silllies/uranus-fpga-board/BOM_HUMAN.csv

Name | Price | Quantity | Description | Link
Nanya Tech NT5CB64M16GP-FL | 6.11 | 4 | RAM 16 bit | https://www.lcsc.com/product-detail/C27258648.html?s_z=n_q_NT5CB64M16GP
AMD/Xilinx Kintex-7 XC7K325T-3FFG900E | 74.26 | 1 | Main FPGA | https://www.lcsc.com/product-detail/C19273096.html?s_z=s_p_XC7K325T-3FFG900E
AK7DAF1-200.0000T2 | 8.91 | 1 | 200 MHz Crystal Oscillator | https://www.digikey.com/en/products/detail/abracon-llc/AK7DAF1-200-0000T2/10268673
Samtec ASP-134488-01 | 24.74 | 1 | FMC HPC | https://www.lcsc.com/product-detail/C2762238.html?s_z=n_q_ASP-134488-01
Total Cost | 132.35
