silllies/uranus-fpga-board/KiCad/uranus-fpga-board/uranus-fpga-board.kicad_pcb

## KiCad design KiCad/uranus-fpga-board/uranus-fpga-board.kicad_pcb (2026-10-22)

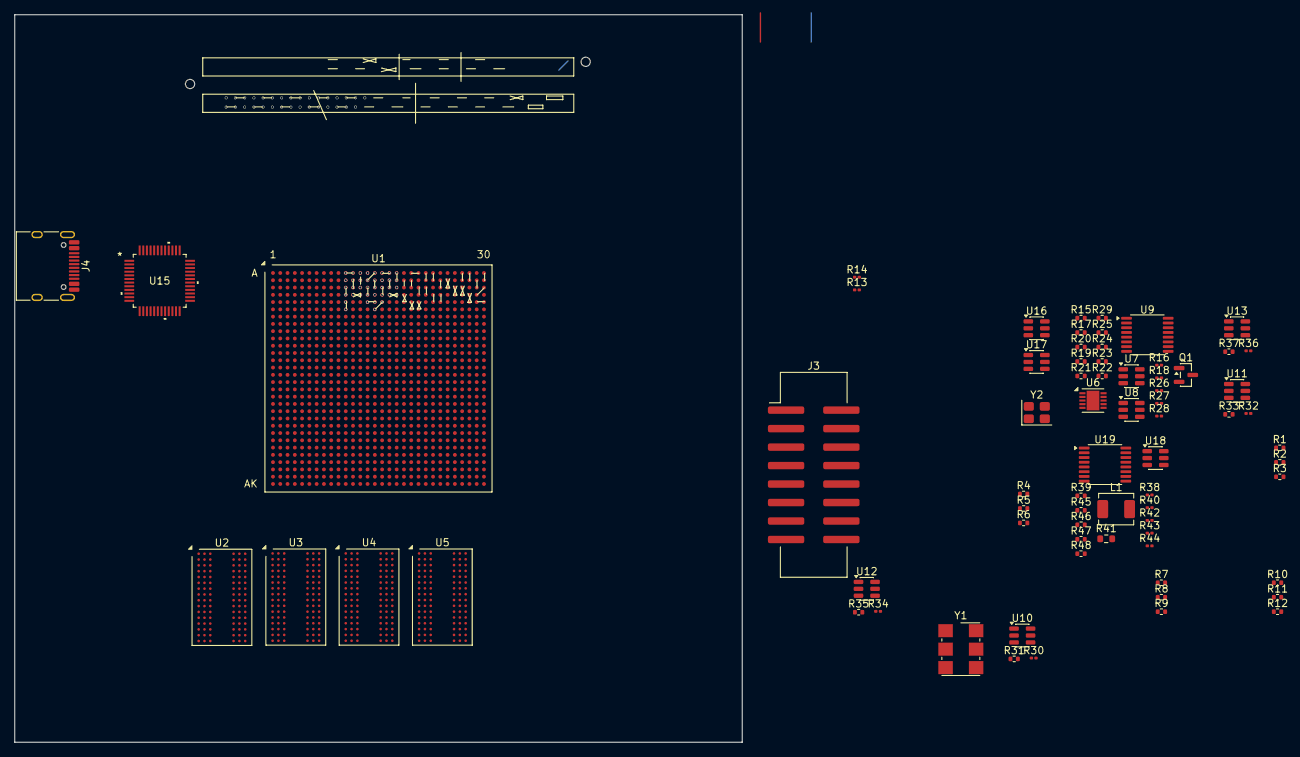
[picture p41: board KiCad/uranus-fpga-board/uranus-fpga-board.kicad_pcb from above]

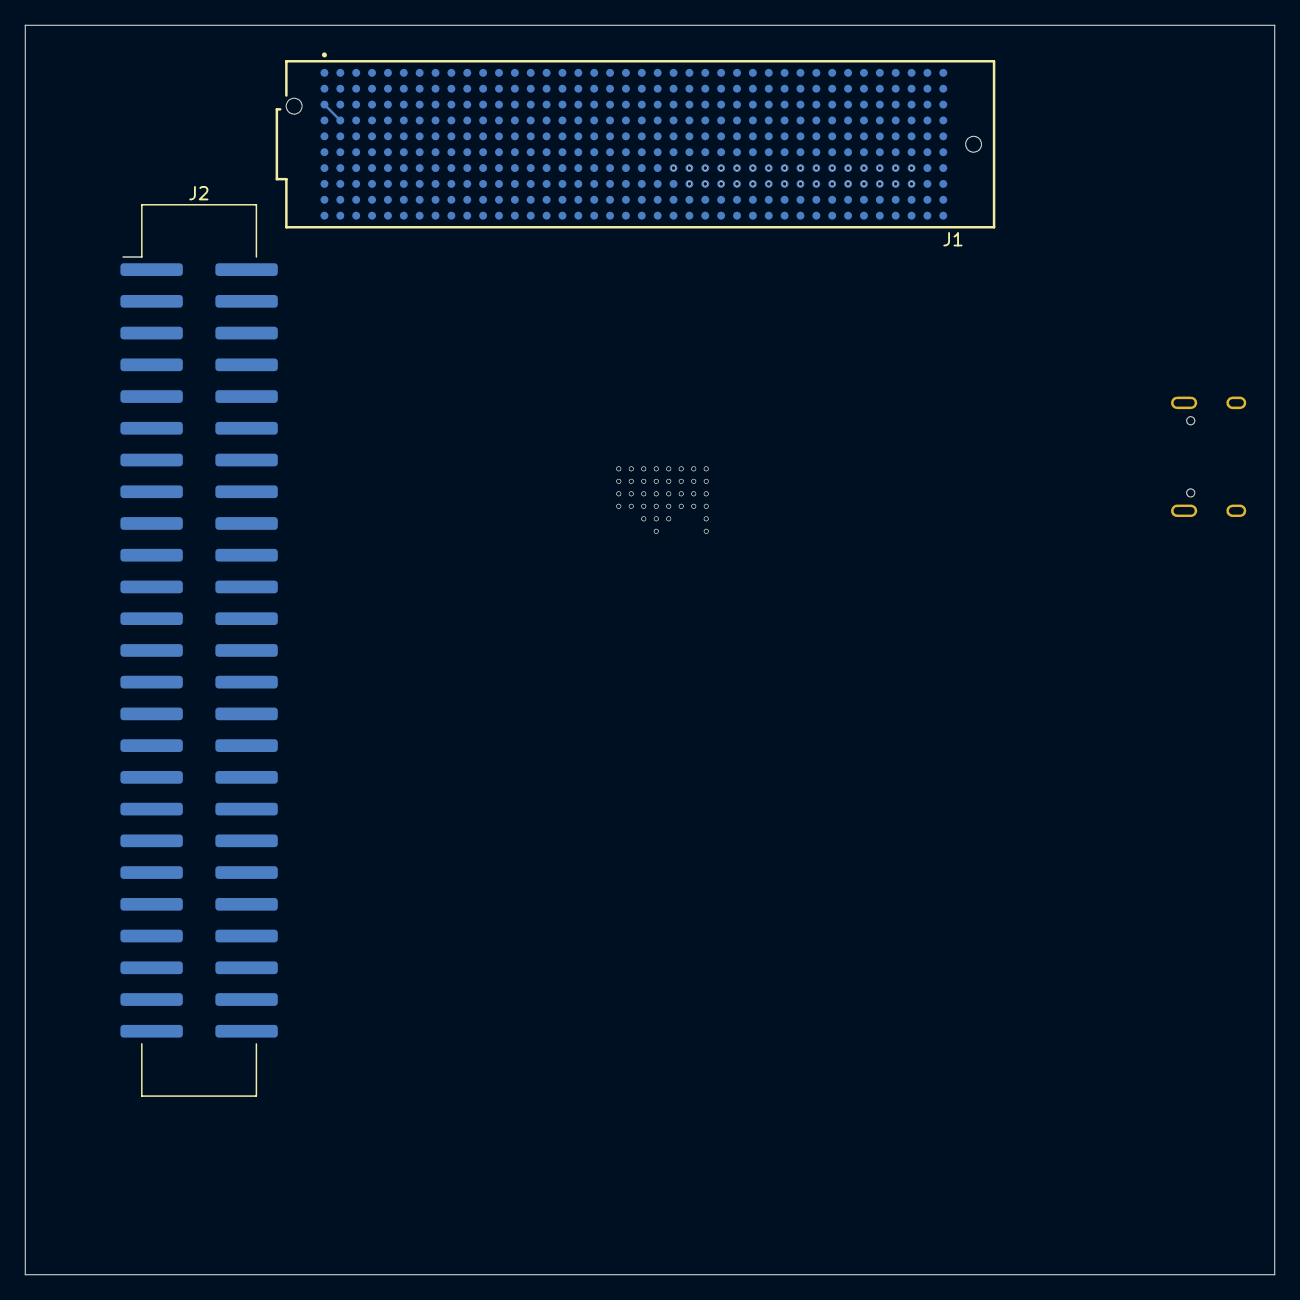
[picture p42: board KiCad/uranus-fpga-board/uranus-fpga-board.kicad_pcb from below]

Board: 8 copper layers, 100.0 x 100.0 mm, 74 parts (2 on the bottom side), 244 nets.

Parts:
J1: ASP-134486-01; SAMTEC_ASP-134486-01
J2: 1040100018; IDC-Header_2x25_P2.54mm_Vertical_SMD
J3: IDC 2x8; IDC-Header_2x08_P2.54mm_Vertical_SMD
J4: TYPE-C-31-M-12; USB_C_Receptacle_HRO_TYPE-C-31-M-12
L1: 2.2 μH; L_Chilisin_BMRA00040415
Q1: 2N7002; SOT-23
R1, R2, R4, R5, R7, R8, R10, R11: 1 kΩ; R_0402_1005Metric
R3, R6, R9, R12: 240 Ω; R_0402_1005Metric
R13, R14, R16, R38: 10 kΩ; R_0201_0603Metric
R15: 1.8 kΩ; R_0402_1005Metric
R17: 200 kΩ; R_0402_1005Metric
R18: 7.5 kΩ; R_0201_0603Metric
R19, R20, R22: 57.6 kΩ; R_0402_1005Metric
R21: 232 kΩ; R_0402_1005Metric
R23: 41.2 kΩ; R_0402_1005Metric
R24: 27.4 kΩ; R_0402_1005Metric
R25: 21.5 kΩ; R_0402_1005Metric
R26, R27, R28, R42, R43, R44: 200 kΩ; R_0201_0603Metric
R29: 15.8 kΩ; R_0402_1005Metric
R30, R32, R34, R36: 499 Ω; R_0201_0603Metric
R31, R33, R35, R37: 7.68 kΩ; R_0402_1005Metric
R39: 4.7 kΩ; R_0402_1005Metric
R40: 30 kΩ; R_0201_0603Metric
R41: 8.98 kΩ; R_0603_1608Metric
R45: 13 kΩ; R_0402_1005Metric
R46: 22.1 kΩ; R_0402_1005Metric
R47: 30.9 kΩ; R_0402_1005Metric
R48: 52.3 kΩ; R_0402_1005Metric
U1: XC7K325T-3FFG900E; Xilinx_FFG900_FFG901
U2, U3, U4, U5: NT5CB64M16GP-FL; FBGA-96_8x13mm_Layout9x16_P0.8mm
U6: SY6874DBC; DFN-10-1EP_3x3mm_P0.5mm_EP1.75x2.7mm
U7: TPS2553DBVR; SOT-23-6
U8: SY6288F1ABC; SOT-23-6
U9, U19: TMUX1108; TSSOP-16_4.4x5mm_P0.65mm
U10, U11, U12, U13: TLV6700DDCR; SOT-23-6
U15: FT232HL-REEL; LQFP48_FT232HL_FTD
U16: 93LC56BT; SOT-23-6
U17: USBLC6-2SC6; SOT-23-6
U18: TPS564201DDCR; SOT-23-6
Y1: SX7DF200.000B20F30DNN; Oscillator_SMD_IDT_JU6-6_7.0x5.0mm_P2.54mm
Y2: 3225-12-20-10-10/4B; Crystal_SMD_3225-4Pin_3.2x2.5mm

Connections:
+1V0: U1.M11 (VCCINT), U1.M13 (VCCINT), U1.M15 (VCCINT), U1.M17 (VCCINT), U1.N10 (VCCINT), U1.N12 (VCCINT), U1.N14 (VCCINT), U1.N16 (VCCBRAM), U1.N18 (VCCINT), U1.P11 (VCCINT), U1.P17 (VCCINT), U1.R10 (VCCINT), U1.R12 (VCCINT), U1.R16 (VCCBRAM), U1.R18 (VCCINT), U1.T11 (VCCINT), U1.T17 (VCCINT), U1.U10 (VCCINT), U1.U12 (VCCINT), U1.U16 (VCCBRAM), U1.U18 (VCCINT), U1.V17 (VCCINT), U1.W16 (VCCBRAM), U1.W18 (VCCINT)
+1V5: R1.1, R4.1, R7.1, R10.1, U1.AA9 (VCCO_33), U1.AA19 (VCCO_32), U1.AB16 (VCCO_32), U1.AC3 (VCCO_34), U1.AC13 (VCCO_33), U1.AD10 (VCCO_33), U1.AE7 (VCCO_34), U1.AE17 (VCCO_32), U1.AF4 (VCCO_34), U1.AF14 (VCCO_32), U1.AG1 (VCCO_34), U1.AG11 (VCCO_33), U1.AH8 (VCCO_34), U1.AH18 (VCCO_32), U1.AJ5 (VCCO_34), U1.AJ15 (VCCO_32), U1.AK2 (VCCO_34), U1.AK12 (VCCO_33), U1.Y12 (VCCO_33), U2.A1 (VDDQ), U2.A8 (VDDQ), U2.B2 (VDD), U2.C1 (VDDQ), U2.C9 (VDDQ), U2.D2 (VDDQ), U2.D9 (VDD), U2.E9 (VDDQ), U2.F1 (VDDQ), U2.G7 (VDD), U2.H2 (VDDQ), U2.H9 (VDDQ), U2.K2 (VDD), U2.K8 (VDD), U2.N1 (VDD), U2.N9 (VDD), U2.R1 (VDD), U2.R9 (VDD), U3.A1 (VDDQ), U3.A8 (VDDQ), U3.B2 (VDD), U3.C1 (VDDQ), U3.C9 (VDDQ), U3.D2 (VDDQ), U3.D9 (VDD), U3.E9 (VDDQ), U3.F1 (VDDQ), U3.G7 (VDD), U3.H2 (VDDQ), U3.H9 (VDDQ), U3.K2 (VDD), U3.K8 (VDD), U3.N1 (VDD), U3.N9 (VDD), U3.R1 (VDD), U3.R9 (VDD), U4.A1 (VDDQ), U4.A8 (VDDQ), U4.B2 (VDD), U4.C1 (VDDQ), U4.C9 (VDDQ), U4.D2 (VDDQ), U4.D9 (VDD), U4.E9 (VDDQ), U4.F1 (VDDQ), U4.G7 (VDD), U4.H2 (VDDQ), U4.H9 (VDDQ), U4.K2 (VDD), U4.K8 (VDD), U4.N1 (VDD), U4.N9 (VDD), U4.R1 (VDD), U4.R9 (VDD), U5.A1 (VDDQ), U5.A8 (VDDQ), U5.B2 (VDD), U5.C1 (VDDQ), U5.C9 (VDDQ), U5.D2 (VDDQ), U5.D9 (VDD), U5.E9 (VDDQ), U5.F1 (VDDQ), U5.G7 (VDD), U5.H2 (VDDQ), U5.H9 (VDDQ), U5.K2 (VDD), U5.K8 (VDD), U5.N1 (VDD), U5.N9 (VDD), U5.R1 (VDD), U5.R9 (VDD)
+1V8: U1.P13 (VCCAUX), U1.P15 (VCCADC_0), U1.T13 (VCCAUX), U1.V13 (VCCAUX)
+2V0: U1.V11 (VCCAUX_IO_G0), U1.W10 (VCCAUX_IO_G0), U1.W12 (VCCAUX_IO_G0)
+3V3: J3.1 (VIN), R13.1, R16.1, U1.AB6 (VCCO_0), U1.J25 (VCCO_15), U1.K22 (VCCO_15), U1.L29 (VCCO_15), U1.M26 (VCCO_15), U1.N23 (VCCO_15), U1.P20 (VCCO_15), U1.T9 (VCCO_0), U7.1 (IN), U7.3 (EN), U8.6 (IN), U10.5 (VDD), U11.5 (VDD), U12.5 (VDD), U13.5 (VDD), Y1.6 (VDD)
+3V3AUX: J1.D32 (3P3VAUX), R19.2, U7.6 (OUT)
+3V3_P: J1.C39 (3P3V), J1.D36 (3P3V), J1.D38 (3P3V), J1.D40 (3P3V), R14.1, R20.2, U8.1 (OUT)
+5V0: U9.2 (EN), U9.13 (VDD), U19.2 (EN), U19.13 (VDD)
+12V0: J1.C35 (12P0V), J1.C37 (12P0V), U6.1 (IN), U18.3 (VIN)
+12V0_P: R21.2, U6.8 (OUT), U6.9 (VOUT), U6.10 (VOUT)
/FMC/CLK0_N: J1.H05 (CLK0_M2C_N), U1.B25 (IO_L12N_T1_MRCC_16)
/FMC/CLK0_P: J1.H04 (CLK0_M2C_P), U1.C25 (IO_L12P_T1_MRCC_16)
/FMC/CLK1_N: J1.G03 (CLK1_M2C_N), U1.D28 (IO_L14N_T2_SRCC_16)
/FMC/CLK1_P: J1.G02 (CLK1_M2C_P), U1.E28 (IO_L14P_T2_SRCC_16)
/FMC/DP0_C2M_N: J1.C03 (DP0_C2M_N), U1.B1 (MGTXTXN2_118)
/FMC/DP0_C2M_P: J1.C02 (DP0_C2M_P), U1.B2 (MGTXTXP2_118)
/FMC/DP0_M2C_N: J1.C07 (DP0_M2C_N), U1.B5 (MGTXRXN2_118)
/FMC/DP0_M2C_P: J1.C06 (DP0_M2C_P), U1.B6 (MGTXRXP2_118)
/FMC/GTXCLK0_N: J1.D05 (GBTCLK0_M2C_N), U1.C7 (MGTREFCLK0N_118)
/FMC/GTXCLK0_P: J1.D04 (GBTCLK0_M2C_P), U1.C8 (MGTREFCLK0P_118)
/FMC/LA00_CC_N: J1.G07 (LA00_CC_N), U1.C27 (IO_L13N_T2_MRCC_16)
/FMC/LA00_CC_P: J1.G06 (LA00_CC_P), U1.D27 (IO_L13P_T2_MRCC_16)
/FMC/LA01_N: J1.D09 (LA01_N), U1.E29 (IO_L18P_T2_16)
/FMC/LA01_P: J1.D08 (LA01_P), U1.E30 (IO_L18N_T2_16)
/FMC/LA02_N: J1.H08 (LA02_N), U1.D29 (IO_L16P_T2_16)
/FMC/LA02_P: J1.H07 (LA02_P), U1.C30 (IO_L16N_T2_16)
/FMC/LA03_N: J1.G10 (LA03_N), U1.A30 (IO_L17N_T2_16)
/FMC/LA03_P: J1.G09 (LA03_P), U1.B30 (IO_L17P_T2_16)
/FMC/LA04_N: J1.H11 (LA04_N), U1.B29 (IO_L15N_T2_DQS_16)
/FMC/LA04_P: J1.H10 (LA04_P), U1.C29 (IO_L15P_T2_DQS_16)
/FMC/LA05_N: J1.D12 (LA05_N), U1.D23 (IO_L2N_T0_16)
/FMC/LA05_P: J1.D11 (LA05_P), U1.E23 (IO_L2P_T0_16)
/FMC/LA06_N: J1.C11 (LA06_N), U1.D24 (IO_L4N_T0_16)
/FMC/LA06_P: J1.C10 (LA06_P), U1.E24 (IO_L4P_T0_16)
/FMC/LA07_N: J1.H14 (LA07_N), U1.A27 (IO_L7N_T1_16)
/FMC/LA07_P: J1.H13 (LA07_P), U1.B27 (IO_L7P_T1_16)
/FMC/LA08_N: J1.G13 (LA08_N), U1.A28 (IO_L9N_T1_DQS_16)
/FMC/LA08_P: J1.G12 (LA08_P), U1.B28 (IO_L9P_T1_DQS_16)
/FMC/LA09_N: J1.D15 (LA09_N), U1.C22 (IO_L10N_T1_17)
/FMC/LA09_P: J1.D14 (LA09_P), U1.D22 (IO_L10P_T1_17)
/FMC/LA10_N: J1.C15 (LA10_N), U1.C21 (IO_L8N_T1_17)
/FMC/LA10_P: J1.C14 (LA10_P), U1.D21 (IO_L8P_T1_17)
/FMC/LA11_N: J1.H17 (LA11_N), U1.A23 (IO_L1N_T0_16)
/FMC/LA11_P: J1.H16 (LA11_P), U1.B23 (IO_L1P_T0_16)
/FMC/LA12_N: J1.G16 (LA12_N), U1.B24 (IO_L8N_T1_16)
/FMC/LA12_P: J1.G15 (LA12_P), U1.C24 (IO_L8P_T1_16)
/FMC/LA13_N: J1.D18 (LA13_N), U1.D19 (IO_L14N_T2_SRCC_17)
/FMC/LA13_P: J1.D17 (LA13_P), U1.E19 (IO_L14P_T2_SRCC_17)
/FMC/LA14_N: J1.C19 (LA14_N), U1.C16 (IO_L15N_T2_DQS_17)
/FMC/LA14_P: J1.C18 (LA14_P), U1.D16 (IO_L15P_T2_DQS_17)
/FMC/LA15_N: J1.H20 (LA15_N), U1.A20 (IO_L21P_T3_DQS_17)
/FMC/LA15_P: J1.H19 (LA15_P), U1.A21 (IO_L21N_T3_DQS_17)
/FMC/LA16_N: J1.G19 (LA16_N), U1.A22 (IO_L23N_T3_17)
/FMC/LA16_P: J1.G18 (LA16_P), U1.B22 (IO_L23P_T3_17)
/FMC/LA17_CC_N: J1.D21 (LA17_CC_N), U1.D13 (IO_L13N_T2_MRCC_18)
/FMC/LA17_CC_P: J1.D20 (LA17_CC_P), U1.D12 (IO_L13P_T2_MRCC_18)
/FMC/LA18_CC_N: J1.C23 (LA18_CC_N), U1.D18 (IO_L13N_T2_MRCC_17)
/FMC/LA18_CC_P: J1.C22 (LA18_CC_P), U1.D17 (IO_L13P_T2_MRCC_17)
/FMC/LA19_N: J1.H23 (LA19_N), U1.C19 (IO_L24P_T3_17)
/FMC/LA19_P: J1.H22 (LA19_P), U1.B19 (IO_L24N_T3_17)
/FMC/LA20_N: J1.G22 (LA20_N), U1.C20 (IO_L19P_T3_17)
/FMC/LA20_P: J1.G21 (LA20_P), U1.B20 (IO_L19N_T3_VREF_17)
/FMC/LA21_N: J1.H26 (LA21_N), U1.C17 (IO_L17P_T2_17)
/FMC/LA21_P: J1.H25 (LA21_P), U1.B17 (IO_L17N_T2_17)
/FMC/LA22_N: J1.G25 (LA22_N), U1.B18 (IO_L22P_T3_17)
/FMC/LA22_P: J1.G24 (LA22_P), U1.A18 (IO_L22N_T3_17)
/FMC/LA23_N: J1.D24 (LA23_N), U1.F15 (IO_L19P_T3_18)
/FMC/LA23_P: J1.D23 (LA23_P), U1.E16 (IO_L19N_T3_VREF_18)
/FMC/LA24_N: J1.H29 (LA24_N), U1.C15 (IO_L23P_T3_18)
/FMC/LA24_P: J1.H28 (LA24_P), U1.B15 (IO_L23N_T3_18)
/FMC/LA25_N: J1.G28 (LA25_N), U1.A16 (IO_L20P_T3_17)
/FMC/LA25_P: J1.G27 (LA25_P), U1.A17 (IO_L20N_T3_17)
/FMC/LA26_N: J1.D27 (LA26_N), U1.E11 (IO_L16N_T2_18)
/FMC/LA26_P: J1.D26 (LA26_P), U1.F11 (IO_L16P_T2_18)
/FMC/LA27_N: J1.C27 (LA27_N), U1.E14 (IO_L20P_T3_18)
/FMC/LA27_P: J1.C26 (LA27_P), U1.E15 (IO_L20N_T3_18)
/FMC/LA28_N: J1.H32 (LA28_N), U1.D14 (IO_L21P_T3_DQS_18)
/FMC/LA28_P: J1.H31 (LA28_P), U1.C14 (IO_L21N_T3_DQS_18)
/FMC/LA29_N: J1.G31 (LA29_N), U1.B14 (IO_L24P_T3_18)
/FMC/LA29_P: J1.G30 (LA29_P), U1.A15 (IO_L24N_T3_18)
/FMC/LA30_N: J1.H35 (LA30_N), U1.A11 (IO_L17P_T2_18)
/FMC/LA30_P: J1.H34 (LA30_P), U1.A12 (IO_L17N_T2_18)
/FMC/LA31_N: J1.G34 (LA31_N), U1.B13 (IO_L22P_T3_18)
/FMC/LA31_P: J1.G33 (LA31_P), U1.A13 (IO_L22N_T3_18)
/FMC/LA32_N: J1.H38 (LA32_N), U1.D11 (IO_L18P_T2_18)
/FMC/LA32_P: J1.H37 (LA32_P), U1.C11 (IO_L18N_T2_18)
/FMC/LA33_N: J1.G37 (LA33_N), U1.C12 (IO_L15P_T2_DQS_18)
/FMC/LA33_P: J1.G36 (LA33_P), U1.B12 (IO_L15N_T2_DQS_18)
/FMC/PG: J1.D01 (PG_C2M), R14.2, U10.1 (OUTA), U10.6 (OUTB), U11.1 (OUTA), U11.6 (OUTB), U12.1 (OUTA), U12.6 (OUTB), U13.1 (OUTA), U13.6 (OUTB)
/FMC/Power Management/PRSNT: Q1.3 (D), R16.2, U6.2 (VIN), U6.3 (VIN), U6.7 (EN), U8.4 (EN)
/FMC/Power Management/Window Comparator +3V3AUX/IN: R19.1, R30.1, U10.3 (INA+)
/FMC/Power Management/Window Comparator +3V3_P/IN: R20.1, R34.1, U12.3 (INA+)
/FMC/Power Management/Window Comparator +12V0_P/IN: R21.1, R32.1, U11.3 (INA+)
/FMC/Power Management/Window Comparator VADJ/IN: R36.1, U9.8 (D), U13.3 (INA+)
/FMC/Power Management/~PRSNT: J1.H02 (~PRSNT_M2C), Q1.1 (G), R13.2
/FMC/REG_EN: R38.1, U18.5 (EN)
/FMC/SEL_A0: R26.2, R42.1, U9.1 (A0), U19.1 (A0)
/FMC/SEL_A1: R27.2, R43.1, U9.16 (A1), U19.16 (A1)
/FMC/SEL_A2: R28.2, R44.1, U9.15 (A2), U19.15 (A2)
/FPGA/CKE: U1.AJ9 (IO_L15P_T2_DQS_33), U2.K9 (CKE), U3.K9 (CKE), U4.K9 (CKE), U5.K9 (CKE)
/FPGA/H0.DM: U1.AF3 (IO_L7P_T1_34), U2.D3 (UDM)
/FPGA/H0.DQ0: U1.AF2 (IO_L7N_T1_34), U2.D7 (DQ8)
/FPGA/H0.DQ1: U1.AE1 (IO_L8P_T1_34), U2.C3 (DQ9)
/FPGA/H0.DQ2: U1.AF1 (IO_L8N_T1_34), U2.C8 (DQ10)
/FPGA/H0.DQ3: U1.AE4 (IO_L10P_T1_34), U2.C2 (DQ11)
/FPGA/H0.DQ4: U1.AE3 (IO_L10N_T1_34), U2.A7 (DQ12)
/FPGA/H0.DQ5: U1.AE5 (IO_L11P_T1_SRCC_34), U2.A2 (DQ13)
/FPGA/H0.DQ6: U1.AF5 (IO_L11N_T1_SRCC_34), U2.B8 (DQ14)
/FPGA/H0.DQ7: U1.AF6 (IO_L12P_T1_MRCC_34), U2.A3 (DQ15)
/FPGA/H0.DQS_N: U1.AG3 (IO_L9N_T1_DQS_34), U2.B7 (~UDQS)
/FPGA/H0.DQS_P: U1.AG4 (IO_L9P_T1_DQS_34), U2.C7 (UDQS)
/FPGA/H1.DM: U1.AF8 (IO_L19P_T3_34), U3.D3 (UDM)
/FPGA/H1.DQ0: U1.AF7 (IO_L20P_T3_34), U3.D7 (DQ8)
/FPGA/H1.DQ1: U1.AG7 (IO_L20N_T3_34), U3.C3 (DQ9)
/FPGA/H1.DQ2: U1.AJ6 (IO_L22P_T3_34), U3.C8 (DQ10)
/FPGA/H1.DQ3: U1.AK6 (IO_L22N_T3_34), U3.C2 (DQ11)
/FPGA/H1.DQ4: U1.AJ8 (IO_L23P_T3_34), U3.A7 (DQ12)
/FPGA/H1.DQ5: U1.AK8 (IO_L23N_T3_34), U3.A2 (DQ13)
/FPGA/H1.DQ6: U1.AK5 (IO_L24P_T3_34), U3.B8 (DQ14)
/FPGA/H1.DQ7: U1.AK4 (IO_L24N_T3_34), U3.A3 (DQ15)
/FPGA/H1.DQS_N: U1.AJ7 (IO_L21N_T3_DQS_34), U3.B7 (~UDQS)
/FPGA/H1.DQS_P: U1.AH7 (IO_L21P_T3_DQS_34), U3.C7 (UDQS)
/FPGA/H2.DM: U1.AJ19 (IO_L7P_T1_32), U4.D3 (UDM)
/FPGA/H2.DQ0: U1.AK19 (IO_L7N_T1_32), U4.D7 (DQ8)
/FPGA/H2.DQ1: U1.AG19 (IO_L8P_T1_32), U4.C3 (DQ9)
/FPGA/H2.DQ2: U1.AH19 (IO_L8N_T1_32), U4.C8 (DQ10)
/FPGA/H2.DQ3: U1.AD19 (IO_L10P_T1_32), U4.C2 (DQ11)
/FPGA/H2.DQ4: U1.AE19 (IO_L10N_T1_32), U4.A7 (DQ12)
/FPGA/H2.DQ5: U1.AF18 (IO_L11P_T1_SRCC_32), U4.A2 (DQ13)
/FPGA/H2.DQ6: U1.AG18 (IO_L11N_T1_SRCC_32), U4.B8 (DQ14)
/FPGA/H2.DQ7: U1.AF17 (IO_L12P_T1_MRCC_32), U4.A3 (DQ15)
/FPGA/H2.DQS_N: U1.AK18 (IO_L9N_T1_DQS_32), U4.B7 (~UDQS)
/FPGA/H2.DQS_P: U1.AJ18 (IO_L9P_T1_DQS_32), U4.C7 (UDQS)
/FPGA/H3.DM: U1.AA18 (IO_L16P_T2_32), U5.D3 (UDM)
/FPGA/H3.DQ0: U1.AD18 (IO_L13P_T2_MRCC_32), U5.D7 (DQ8)
/FPGA/H3.DQ1: U1.AE18 (IO_L13N_T2_MRCC_32), U5.C3 (DQ9)
/FPGA/H3.DQ2: U1.AD17 (IO_L14P_T2_SRCC_32), U5.C8 (DQ10)
/FPGA/H3.DQ3: U1.AD16 (IO_L14N_T2_SRCC_32), U5.C2 (DQ11)
/FPGA/H3.DQ4: U1.AB18 (IO_L16N_T2_32), U5.A7 (DQ12)
/FPGA/H3.DQ5: U1.AB19 (IO_L17P_T2_32), U5.A2 (DQ13)
/FPGA/H3.DQ6: U1.AC19 (IO_L17N_T2_32), U5.B8 (DQ14)
/FPGA/H3.DQ7: U1.AB17 (IO_L18P_T2_32), U5.A3 (DQ15)
/FPGA/H3.DQS_N: U1.Y18 (IO_L15N_T2_DQS_32), U5.B7 (~UDQS)
/FPGA/H3.DQS_P: U1.Y19 (IO_L15P_T2_DQS_32), U5.C7 (UDQS)
/FPGA/L0.DM: U1.AD4 (IO_L1P_T0_34), U2.E7 (LDM)
/FPGA/L0.DQ0: U1.AD3 (IO_L1N_T0_34), U2.E3 (DQ0)
/FPGA/L0.DQ1: U1.AC2 (IO_L2P_T0_34), U2.F7 (DQ1)
/FPGA/L0.DQ2: U1.AC1 (IO_L2N_T0_34), U2.F2 (DQ2)
/FPGA/L0.DQ3: U1.AC5 (IO_L4P_T0_34), U2.F8 (DQ3)
/FPGA/L0.DQ4: U1.AC4 (IO_L4N_T0_34), U2.H3 (DQ4)
/FPGA/L0.DQ5: U1.AD6 (IO_L5P_T0_34), U2.H8 (DQ5)
/FPGA/L0.DQ6: U1.AE6 (IO_L5N_T0_34), U2.G2 (DQ6)
/FPGA/L0.DQ7: U1.AC7 (IO_L6P_T0_34), U2.H7 (DQ7)
/FPGA/L0.DQS_N: U1.AD1 (IO_L3N_T0_DQS_34), U2.G3 (~LDQS)
/FPGA/L0.DQS_P: U1.AD2 (IO_L3P_T0_DQS_34), U2.F3 (LDQS)
/FPGA/L1.DM: U1.AH2 (IO_L16P_T2_34), U3.E7 (LDM)
/FPGA/L1.DQ0: U1.AH4 (IO_L13P_T2_MRCC_34), U3.E3 (DQ0)
/FPGA/L1.DQ1: U1.AJ4 (IO_L13N_T2_MRCC_34), U3.F7 (DQ1)
/FPGA/L1.DQ2: U1.AH6 (IO_L14P_T2_SRCC_34), U3.F2 (DQ2)
/FPGA/L1.DQ3: U1.AH5 (IO_L14N_T2_SRCC_34), U3.F8 (DQ3)
/FPGA/L1.DQ4: U1.AJ2 (IO_L16N_T2_34), U3.H3 (DQ4)
/FPGA/L1.DQ5: U1.AJ1 (IO_L17P_T2_34), U3.H8 (DQ5)
/FPGA/L1.DQ6: U1.AK1 (IO_L17N_T2_34), U3.G2 (DQ6)
/FPGA/L1.DQ7: U1.AJ3 (IO_L18P_T2_34), U3.H7 (DQ7)
/FPGA/L1.DQS_N: U1.AH1 (IO_L15N_T2_DQS_34), U3.G3 (~LDQS)
/FPGA/L1.DQS_P: U1.AG2 (IO_L15P_T2_DQS_34), U3.F3 (LDQS)
/FPGA/L2.DM: U1.AK16 (IO_L1P_T0_32), U4.E7 (LDM)
/FPGA/L2.DQ0: U1.AK15 (IO_L1N_T0_32), U4.E3 (DQ0)
/FPGA/L2.DQ1: U1.AG15 (IO_L2P_T0_32), U4.F7 (DQ1)
/FPGA/L2.DQ2: U1.AH15 (IO_L2N_T0_32), U4.F2 (DQ2)
/FPGA/L2.DQ3: U1.AF15 (IO_L4P_T0_32), U4.F8 (DQ3)
/FPGA/L2.DQ4: U1.AG14 (IO_L4N_T0_32), U4.H3 (DQ4)
/FPGA/L2.DQ5: U1.AH17 (IO_L5P_T0_32), U4.H8 (DQ5)
/FPGA/L2.DQ6: U1.AJ17 (IO_L5N_T0_32), U4.G2 (DQ6)
/FPGA/L2.DQ7: U1.AE16 (IO_L6P_T0_32), U4.H7 (DQ7)
/FPGA/L2.DQS_N: U1.AJ16 (IO_L3N_T0_DQS_32), U4.G3 (~LDQS)
/FPGA/L2.DQS_P: U1.AH16 (IO_L3P_T0_DQS_32), U4.F3 (LDQS)
/FPGA/L3.DM: U1.AE15 (IO_L19P_T3_32), U5.E7 (LDM)
/FPGA/L3.DQ0: U1.AA15 (IO_L20P_T3_32), U5.E3 (DQ0)
/FPGA/L3.DQ1: U1.AB15 (IO_L20N_T3_32), U5.F7 (DQ1)
/FPGA/L3.DQ2: U1.AC14 (IO_L22P_T3_32), U5.F2 (DQ2)
/FPGA/L3.DQ3: U1.AD14 (IO_L22N_T3_32), U5.F8 (DQ3)
/FPGA/L3.DQ4: U1.AA17 (IO_L23P_T3_32), U5.H3 (DQ4)
/FPGA/L3.DQ5: U1.AA16 (IO_L23N_T3_32), U5.H8 (DQ5)
/FPGA/L3.DQ6: U1.Y16 (IO_L24P_T3_32), U5.G2 (DQ6)
/FPGA/L3.DQ7: U1.Y15 (IO_L24N_T3_32), U5.H7 (DQ7)
/FPGA/L3.DQS_N: U1.AC15 (IO_L21N_T3_DQS_32), U5.G3 (~LDQS)
/FPGA/L3.DQS_P: U1.AC16 (IO_L21P_T3_DQS_32), U5.F3 (LDQS)
/FPGA/ODT: U1.AK9 (IO_L15N_T2_DQS_33), U2.K1 (ODT), U3.K1 (ODT), U4.K1 (ODT), U5.K1 (ODT)
/FPGA/~CAS: U1.AE9 (IO_L10N_T1_33), U2.K3 (~CAS), U3.K3 (~CAS), U4.K3 (~CAS), U5.K3 (~CAS)
/FPGA/~CS: U1.AF11 (IO_L11N_T1_SRCC_33), U2.L2 (~CS), U3.L2 (~CS), U4.L2 (~CS), U5.L2 (~CS)
/FPGA/~RAS: U1.AD9 (IO_L10P_T1_33), U2.J3 (~RAS), U3.J3 (~RAS), U4.J3 (~RAS), U5.J3 (~RAS)
/FPGA/~RESET: U1.AD11 (IO_L12N_T1_MRCC_33), U2.T2 (~RESET), U3.T2 (~RESET), U4.T2 (~RESET), U5.T2 (~RESET)
/FPGA/~WE: U1.AE11 (IO_L11P_T1_SRCC_33), U2.L3 (~WE), U3.L3 (~WE), U4.L3 (~WE), U5.L3 (~WE)
/Power/VADJ/MUX_1V2: R48.1, U19.5 (S2)
/Power/VADJ/MUX_1V5: R47.1, U19.6 (S3)
/Power/VADJ/MUX_1V8: R46.1, U19.7 (S4)
/Power/VADJ/MUX_2V5: R45.1, U19.12 (S5)
/Power/VADJ/MUX_3V3: R41.1, U19.11 (S6)
/Power/VADJ/VFB: R40.2, U18.4 (VFB), U19.8 (D)
/RAM/A0: U1.AD8 (IO_L8P_T1_33), U2.N3 (A0), U3.N3 (A0), U4.N3 (A0), U5.N3 (A0)
/RAM/A1: U1.AC10 (IO_L7N_T1_33), U2.P7 (A1), U3.P7 (A1), U4.P7 (A1), U5.P7 (A1)
/RAM/A2: U1.AB10 (IO_L7P_T1_33), U2.P3 (A2), U3.P3 (A2), U4.P3 (A2), U5.P3 (A2)
/RAM/A3: U1.AB13 (IO_L6N_T0_VREF_33), U2.N2 (A3), U3.N2 (A3), U4.N2 (A3), U5.N2 (A3)
/RAM/A4: U1.AA13 (IO_L6P_T0_33), U2.P8 (A4), U3.P8 (A4), U4.P8 (A4), U5.P8 (A4)
/RAM/A5: U1.AA10 (IO_L5N_T0_33), U2.P2 (A5), U3.P2 (A5), U4.P2 (A5), U5.P2 (A5)
/RAM/A6: U1.AA11 (IO_L5P_T0_33), U2.R8 (A6), U3.R8 (A6), U4.R8 (A6), U5.R8 (A6)
/RAM/A7: U1.Y10 (IO_L4N_T0_33), U2.R2 (A7), U3.R2 (A7), U4.R2 (A7), U5.R2 (A7)
/RAM/A8: U1.Y11 (IO_L4P_T0_33), U2.T8 (A8), U3.T8 (A8), U4.T8 (A8), U5.T8 (A8)
/RAM/A9: U1.AB8 (IO_L2N_T0_33), U2.R3 (A9), U3.R3 (A9), U4.R3 (A9), U5.R3 (A9)
/RAM/A10: U1.AA8 (IO_L2P_T0_33), U2.L7 (A10/AP), U3.L7 (A10/AP), U4.L7 (A10/AP), U5.L7 (A10/AP)
/RAM/A11: U1.AB12 (IO_L1N_T0_33), U2.R7 (A11), U3.R7 (A11), U4.R7 (A11), U5.R7 (A11)
/RAM/A12: U1.AA12 (IO_L1P_T0_33), U2.N7 (A12/~BC), U3.N7 (A12/~BC), U4.N7 (A12/~BC), U5.N7 (A12/~BC)
/RAM/BA0: U1.AC11 (IO_L9N_T1_DQS_33), U2.M2 (BA0), U3.M2 (BA0), U4.M2 (BA0), U5.M2 (BA0)
/RAM/BA1: U1.AC12 (IO_L9P_T1_DQS_33), U2.N8 (BA1), U3.N8 (BA1), U4.N8 (BA1), U5.N8 (BA1)
/RAM/BA2: U1.AE8 (IO_L8N_T1_33), U2.M3 (BA2), U3.M3 (BA2), U4.M3 (BA2), U5.M3 (BA2)
/RAM/CK_N: U1.AC9 (IO_L3N_T0_DQS_33), U2.K7 (~CK), U3.K7 (~CK), U4.K7 (~CK), U5.K7 (~CK)
/RAM/CK_P: U1.AB9 (IO_L3P_T0_DQS_33), U2.J7 (CK), U3.J7 (CK), U4.J7 (CK), U5.J7 (CK)
GND: J1.C01 (GND), J1.C04 (GND), J1.C05 (GND), J1.C08 (GND), J1.C09 (GND), J1.C12 (GND), J1.C13 (GND), J1.C16 (GND), J1.C17 (GND), J1.C20 (GND), J1.C21 (GND), J1.C24 (GND), J1.C25 (GND), J1.C28 (GND), J1.C29 (GND), J1.C32 (GND), J1.C33 (GND), J1.C34 (GA0), J1.C36 (GND), J1.C38 (GND), J1.C40 (GND), J1.D02 (GND), J1.D03 (GND), J1.D06 (GND), J1.D07 (GND), J1.D10 (GND), J1.D13 (GND), J1.D16 (GND), J1.D19 (GND), J1.D22 (GND), J1.D25 (GND), J1.D28 (GND), J1.D35 (GA1), J1.D37 (GND), J1.D39 (GND), J1.G01 (GND), J1.G04 (GND), J1.G05 (GND), J1.G08 (GND), J1.G11 (GND), J1.G14 (GND), J1.G17 (GND), J1.G20 (GND), J1.G23 (GND), J1.G26 (GND), J1.G29 (GND), J1.G32 (GND), J1.G35 (GND), J1.G38 (GND), J1.G40 (GND), J1.H03 (GND), J1.H06 (GND), J1.H09 (GND), J1.H12 (GND), J1.H15 (GND), J1.H18 (GND), J1.H21 (GND), J1.H24 (GND), J1.H27 (GND), J1.H30 (GND), J1.H33 (GND), J1.H36 (GND), J1.H39 (GND), J2.1 (GND), J2.2 (GND), J2.17 (GND), J2.18 (GND), J2.33 (GND), J2.34 (GND), J2.37 (GND), J2.38 (GND), J2.41 (GND), J2.42 (GND), J2.45 (GND), J2.46 (GND), J2.49 (GND), J2.50 (GND), J3.2 (GND), J3.3 (GND), J3.6 (GND), J3.7 (GND), J3.10 (GND), J3.11 (GND), J3.14 (GND), J3.15 (GND), Q1.2 (S), R2.2, R3.2, R5.2, R6.2, R8.2, R9.2, R11.2, R12.2, R15.2, R17.2, R18.2, R26.1, R27.1, R28.1, R31.2, R33.2, R35.2, R37.2, R38.2, R39.2, R41.2, R42.2, R43.2, R44.2, R45.2, R46.2, R47.2, R48.2, U1.A1 (GND), U1.A2 (GND), U1.A5 (GND), U1.A6 (GND), U1.A9 (GND), U1.A14 (GND), U1.A24 (GND), U1.AA1 (GND), U1.AA2 (GND), U1.AA5 (GND), U1.AA6 (GND), U1.AA7 (GND), U1.AA14 (GND), U1.AA24 (GND), U1.AB3 (GND), U1.AB4 (GND), U1.AB11 (GND), U1.AB21 (GND), U1.AC8 (GND), U1.AC18 (GND), U1.AC28 (GND), U1.AD5 (GND), U1.AD15 (GND), U1.AD25 (GND), U1.AE2 (GND), U1.AE12 (GND), U1.AE22 (GND), U1.AF9 (GND), U1.AF19 (GND), U1.AF29 (GND), U1.AG6 (GND), U1.AG16 (GND), U1.AG26 (GND), U1.AH3 (GND), U1.AH13 (GND), U1.AH23 (GND), U1.AJ10 (GND), U1.AJ20 (GND), U1.AJ30 (GND), U1.AK7 (GND), U1.AK17 (GND), U1.AK27 (GND), U1.B4 (GND), U1.B8 (GND), U1.B9 (GND), U1.B11 (GND), U1.B21 (GND), U1.C1 (GND), U1.C2 (GND), U1.C6 (GND), U1.C9 (GND), U1.C10 (VCCBATT_0), U1.C18 (GND), U1.C28 (GND), U1.D4 (GND), U1.D8 (GND), U1.D9 (GND), U1.D15 (GND), U1.D25 (GND), U1.E1 (GND), U1.E2 (GND), U1.E6 (GND), U1.E9 (GND), U1.E12 (GND), U1.E22 (GND), U1.F4 (GND), U1.F8 (GND), U1.F9 (GND), U1.F19 (GND), U1.F29 (GND), U1.G1 (GND), U1.G2 (GND), U1.G6 (GND), U1.G9 (GND), U1.G16 (GND), U1.G26 (GND), U1.H4 (GND), U1.H8 (GND), U1.H9 (GND), U1.H13 (GND), U1.H23 (GND), U1.J1 (GND), U1.J2 (GND), U1.J6 (GND), U1.J9 (GND), U1.J10 (GND), U1.J20 (GND), U1.J30 (GND), U1.K4 (GND), U1.K8 (GND), U1.K9 (GND), U1.K17 (GND), U1.K27 (GND), U1.L1 (GND), U1.L2 (GND), U1.L6 (GND), U1.L9 (GND), U1.L14 (GND), U1.L24 (GND), U1.M4 (GND), U1.M8 (GND), U1.M9 (GND), U1.M12 (GND), U1.M14 (GND), U1.M16 (GND), U1.M18 (GND), U1.M21 (GND), U1.N1 (GND), U1.N2 (GND), U1.N6 (GND), U1.N9 (GND), U1.N11 (GND), U1.N13 (GND), U1.N15 (GND), U1.N17 (GND), U1.N28 (GND), U1.P4 (GND), U1.P8 (GND), U1.P9 (GND), U1.P10 (GND), U1.P12 (GND), U1.P14 (GNDADC_0), U1.P16 (GND), U1.P18 (GND), U1.P25 (GND), U1.R1 (GND), U1.R2 (GND), U1.R6 (GND), U1.R9 (GND), U1.R11 (GND), U1.R13 (GND), U1.R17 (GND), U1.R22 (GND), U1.T4 (GND), U1.T8 (GND), U1.T10 (GND), U1.T12 (GND), U1.T16 (GND), U1.T18 (GND), U1.T19 (GND), U1.T29 (GND), U1.U1 (GND), U1.U2 (GND), U1.U6 (GND), U1.U9 (GND), U1.U11 (GND), U1.U13 (GND), U1.U17 (GND), U1.U26 (GND), U1.V4 (GND), U1.V8 (GND), U1.V9 (GND), U1.V10 (GND), U1.V12 (GND), U1.V14 (GND), U1.V16 (GND), U1.V18 (GND), U1.V23 (GND), U1.W1 (GND), U1.W2 (GND), U1.W6 (GND), U1.W9 (GND), U1.W11 (GND), U1.W13 (GND), U1.W15 (GND), U1.W17 (GND), U1.W20 (GND), U1.W30 (GND), U1.Y3 (GND), U1.Y4 (GND), U1.Y7 (GND), U1.Y8 (GND), U1.Y9 (GND), U1.Y17 (GND), U1.Y27 (GND), U2.A9 (VSS), U2.B1 (VSSQ), U2.B3 (VSS), U2.B9 (VSSQ), U2.D1 (VSSQ), U2.D8 (VSSQ), U2.E1 (VSS), U2.E2 (VSSQ), U2.E8 (VSSQ), U2.F9 (VSSQ), U2.G1 (VSSQ), U2.G8 (VSS), U2.G9 (VSSQ), U2.J2 (VSS), U2.J8 (VSS), U2.M1 (VSS), U2.M9 (VSS), U2.P1 (VSS), U2.P9 (VSS), U2.T1 (VSS), U2.T9 (VSS), U3.A9 (VSS), U3.B1 (VSSQ), U3.B3 (VSS), U3.B9 (VSSQ), U3.D1 (VSSQ), U3.D8 (VSSQ), U3.E1 (VSS), U3.E2 (VSSQ), U3.E8 (VSSQ), U3.F9 (VSSQ), U3.G1 (VSSQ), U3.G8 (VSS), U3.G9 (VSSQ), U3.J2 (VSS), U3.J8 (VSS), U3.M1 (VSS), U3.M9 (VSS), U3.P1 (VSS), U3.P9 (VSS), U3.T1 (VSS), U3.T9 (VSS), U4.A9 (VSS), U4.B1 (VSSQ), U4.B3 (VSS), U4.B9 (VSSQ), U4.D1 (VSSQ), U4.D8 (VSSQ), U4.E1 (VSS), U4.E2 (VSSQ), U4.E8 (VSSQ), U4.F9 (VSSQ), U4.G1 (VSSQ), U4.G8 (VSS), U4.G9 (VSSQ), U4.J2 (VSS), U4.J8 (VSS), U4.M1 (VSS), U4.M9 (VSS), U4.P1 (VSS), U4.P9 (VSS), U4.T1 (VSS), U4.T9 (VSS), U5.A9 (VSS), U5.B1 (VSSQ), U5.B3 (VSS), U5.B9 (VSSQ), U5.D1 (VSSQ), U5.D8 (VSSQ), U5.E1 (VSS), U5.E2 (VSSQ), U5.E8 (VSSQ), U5.F9 (VSSQ), U5.G1 (VSSQ), U5.G8 (VSS), U5.G9 (VSSQ), U5.J2 (VSS), U5.J8 (VSS), U5.M1 (VSS), U5.M9 (VSS), U5.P1 (VSS), U5.P9 (VSS), U5.T1 (VSS), U5.T9 (VSS), U6.11 (GND), U7.2 (GND), U8.2 (GND), U9.3 (VSS), U9.14 (GND), U10.2 (GND), U11.2 (GND), U12.2 (GND), U13.2 (GND), U18.1 (GND), U19.3 (VSS), U19.14 (GND), Y1.3 (GND), Y2.2 (GND_2)
unnamed: J4.A1 (GND), J4.A12 (GND), J4.B1 (GND), J4.B12 (GND)
unnamed: J4.A4 (VBUS), J4.A9 (VBUS), J4.B4 (VBUS), J4.B9 (VBUS)
unnamed: U1.V15 (VCCAUX), U1.W14 (VCCAUX)
unnamed: R1.2, R2.1, U2.H1 (VREFDQ), U2.M8 (VREFCA)
unnamed: R3.1, U2.L8 (ZQ)
unnamed: R4.2, R5.1, U3.H1 (VREFDQ), U3.M8 (VREFCA)
unnamed: R6.1, U3.L8 (ZQ)
unnamed: R7.2, R8.1, U4.H1 (VREFDQ), U4.M8 (VREFCA)
unnamed: R9.1, U4.L8 (ZQ)
unnamed: R10.2, R11.1, U5.H1 (VREFDQ), U5.M8 (VREFCA)
unnamed: R12.1, U5.L8 (ZQ)
unnamed: R18.1, U6.5 (ILIM)
unnamed: R17.1, U7.5 (ILIM)
unnamed: R15.1, U8.5 (ILIM)
unnamed: R29.1, U9.5 (S2)
unnamed: R25.1, U9.6 (S3)
unnamed: R24.1, U9.7 (S4)
unnamed: R23.1, U9.12 (S5)
unnamed: R22.1, U9.11 (S6)
unnamed: R30.2, R31.1, U10.4 (INB-)
unnamed: R32.2, R33.1, U11.4 (INB-)
unnamed: R34.2, R35.1, U12.4 (INB-)
unnamed: R36.2, R37.1, U13.4 (INB-)
unnamed: L1.1, U18.2 (SW)
VADJ: J1.G39 (VADJ), J1.H40 (VADJ), L1.2, R22.2, R23.2, R24.2, R25.2, R29.2, R39.1, R40.1, U1.A19 (VCCO_17), U1.A29 (VCCO_16), U1.B16 (VCCO_17), U1.B26 (VCCO_16), U1.C13 (VCCO_18), U1.C23 (VCCO_16), U1.D10 (VCCO_18), U1.D20 (VCCO_17), U1.D30 (VCCO_16), U1.E17 (VCCO_17), U1.E27 (VCCO_16), U1.F14 (VCCO_18), U1.F24 (VCCO_16), U1.G11 (VCCO_18), U1.G21 (VCCO_17), U1.H18 (VCCO_17), U1.H28 (VCCO_16), U1.J15 (VCCO_18), U1.K12 (VCCO_18), U1.L19 (VCCO_17)
