silllies/uranus-fpga-board/KiCad/uranus-fpga-board/_restore_backup_2026-10-11T01-21-57-021/uranus-fpga-board.kicad_pcb

## KiCad design KiCad/uranus-fpga-board/_restore_backup_2026-10-11T01-21-57-021/uranus-fpga-board.kicad_pcb (2026-10-11)

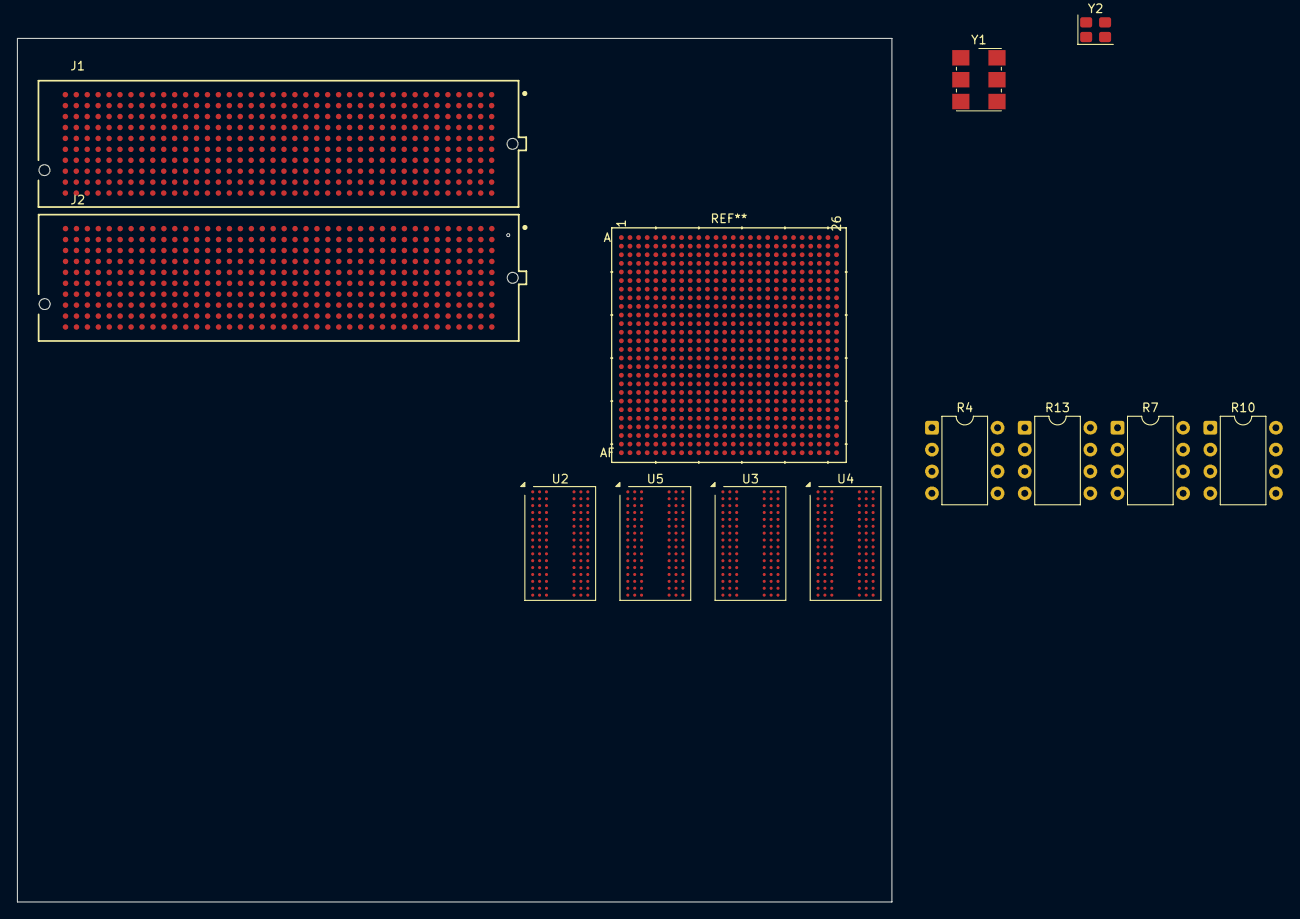
[picture p43: board KiCad/uranus-fpga-board/_restore_backup_2026-10-11T01-21-57-021/uranu… from above]

Board: 8 copper layers, 101.6 x 100.3 mm, 12 parts (0 on the bottom side), 34 nets, no tracks yet.

Parts:
J1, J2: ASP-134488-01; SAMTEC_ASP-134488-01
R4, R7, R10, R13: 240Ω; DIP-8_W7.62mm
U2, U3, U4, U5: AS4C256M16D3; FBGA-96_8x13mm_Layout9x16_P0.8mm
Y1: SX7DF200.000B20F30DNN; Oscillator_SMD_IDT_JU6-6_7.0x5.0mm_P2.54mm
Y2: ASE-xxxMHz; Crystal_SMD_3225-4Pin_3.2x2.5mm

Connections:
+1V5: U2.A1 (VDDQ), U2.A8 (VDDQ), U2.B2 (VDD), U2.C1 (VDDQ), U2.C9 (VDDQ), U2.D2 (VDDQ), U2.D9 (VDD), U2.E9 (VDDQ), U2.F1 (VDDQ), U2.G7 (VDD), U2.H2 (VDDQ), U2.H9 (VDDQ), U2.K2 (VDD), U2.K8 (VDD), U2.N1 (VDD), U2.N9 (VDD), U2.R1 (VDD), U2.R9 (VDD), U3.A1 (VDDQ), U3.A8 (VDDQ), U3.B2 (VDD), U3.C1 (VDDQ), U3.C9 (VDDQ), U3.D2 (VDDQ), U3.D9 (VDD), U3.E9 (VDDQ), U3.F1 (VDDQ), U3.G7 (VDD), U3.H2 (VDDQ), U3.H9 (VDDQ), U3.K2 (VDD), U3.K8 (VDD), U3.N1 (VDD), U3.N9 (VDD), U3.R1 (VDD), U3.R9 (VDD), U4.A1 (VDDQ), U4.A8 (VDDQ), U4.B2 (VDD), U4.C1 (VDDQ), U4.C9 (VDDQ), U4.D2 (VDDQ), U4.D9 (VDD), U4.E9 (VDDQ), U4.F1 (VDDQ), U4.G7 (VDD), U4.H2 (VDDQ), U4.H9 (VDDQ), U4.K2 (VDD), U4.K8 (VDD), U4.N1 (VDD), U4.N9 (VDD), U4.R1 (VDD), U4.R9 (VDD), U5.A1 (VDDQ), U5.A8 (VDDQ), U5.B2 (VDD), U5.C1 (VDDQ), U5.C9 (VDDQ), U5.D2 (VDDQ), U5.D9 (VDD), U5.E9 (VDDQ), U5.F1 (VDDQ), U5.G7 (VDD), U5.H2 (VDDQ), U5.H9 (VDDQ), U5.K2 (VDD), U5.K8 (VDD), U5.N1 (VDD), U5.N9 (VDD), U5.R1 (VDD), U5.R9 (VDD)
A0: U2.N3 (A0), U3.N3 (A0), U4.N3 (A0), U5.N3 (A0)
A1: U2.P7 (A1), U3.P7 (A1), U4.P7 (A1), U5.P7 (A1)
A2: U2.P3 (A2), U3.P3 (A2), U4.P3 (A2), U5.P3 (A2)
A3: U2.N2 (A3), U3.N2 (A3), U4.N2 (A3), U5.N2 (A3)
A4: U2.P8 (A4), U3.P8 (A4), U4.P8 (A4), U5.P8 (A4)
A5: U2.P2 (A5), U3.P2 (A5), U4.P2 (A5), U5.P2 (A5)
A6: U2.R8 (A6), U3.R8 (A6), U4.R8 (A6), U5.R8 (A6)
A7: U2.R2 (A7), U3.R2 (A7), U4.R2 (A7), U5.R2 (A7)
A8: U2.T8 (A8), U3.T8 (A8), U4.T8 (A8), U5.T8 (A8)
A9: U2.R3 (A9), U3.R3 (A9), U4.R3 (A9), U5.R3 (A9)
A10: U2.L7 (A10/AP), U3.L7 (A10/AP), U4.L7 (A10/AP), U5.L7 (A10/AP)
A11: U2.R7 (A11), U3.R7 (A11), U4.R7 (A11), U5.R7 (A11)
A12: U2.N7 (A12/~BC), U3.N7 (A12/~BC), U4.N7 (A12/~BC), U5.N7 (A12/~BC)
BA0: U2.M2 (BA0), U3.M2 (BA0), U4.M2 (BA0), U5.M2 (BA0)
BA1: U2.N8 (BA1), U3.N8 (BA1), U4.N8 (BA1), U5.N8 (BA1)
BA2: U2.M3 (BA2), U3.M3 (BA2), U4.M3 (BA2), U5.M3 (BA2)
CAS: U2.K3 (~CAS), U3.K3 (~CAS), U4.K3 (~CAS), U5.K3 (~CAS)
CKE: U2.K9 (CKE), U3.K9 (CKE), U4.K9 (CKE), U5.K9 (CKE)
CK_N: U2.K7 (~CK), U3.K7 (~CK), U4.K7 (~CK), U5.K7 (~CK)
CK_P: U2.J7 (CK), U3.J7 (CK), U4.J7 (CK), U5.J7 (CK)
CS: U2.L2 (~CS), U3.L2 (~CS), U4.L2 (~CS), U5.L2 (~CS)
GND: R4.1, R7.1, R10.1, R13.1, U2.A9 (VSS), U2.B1 (VSSQ), U2.B3 (VSS), U2.B9 (VSSQ), U2.D1 (VSSQ), U2.D8 (VSSQ), U2.E1 (VSS), U2.E2 (VSSQ), U2.E8 (VSSQ), U2.F9 (VSSQ), U2.G1 (VSSQ), U2.G8 (VSS), U2.G9 (VSSQ), U2.J2 (VSS), U2.J8 (VSS), U2.M1 (VSS), U2.M9 (VSS), U2.P1 (VSS), U2.P9 (VSS), U2.T1 (VSS), U2.T9 (VSS), U3.A9 (VSS), U3.B1 (VSSQ), U3.B3 (VSS), U3.B9 (VSSQ), U3.D1 (VSSQ), U3.D8 (VSSQ), U3.E1 (VSS), U3.E2 (VSSQ), U3.E8 (VSSQ), U3.F9 (VSSQ), U3.G1 (VSSQ), U3.G8 (VSS), U3.G9 (VSSQ), U3.J2 (VSS), U3.J8 (VSS), U3.M1 (VSS), U3.M9 (VSS), U3.P1 (VSS), U3.P9 (VSS), U3.T1 (VSS), U3.T9 (VSS), U4.A9 (VSS), U4.B1 (VSSQ), U4.B3 (VSS), U4.B9 (VSSQ), U4.D1 (VSSQ), U4.D8 (VSSQ), U4.E1 (VSS), U4.E2 (VSSQ), U4.E8 (VSSQ), U4.F9 (VSSQ), U4.G1 (VSSQ), U4.G8 (VSS), U4.G9 (VSSQ), U4.J2 (VSS), U4.J8 (VSS), U4.M1 (VSS), U4.M9 (VSS), U4.P1 (VSS), U4.P9 (VSS), U4.T1 (VSS), U4.T9 (VSS), U5.A9 (VSS), U5.B1 (VSSQ), U5.B3 (VSS), U5.B9 (VSSQ), U5.D1 (VSSQ), U5.D8 (VSSQ), U5.E1 (VSS), U5.E2 (VSSQ), U5.E8 (VSSQ), U5.F9 (VSSQ), U5.G1 (VSSQ), U5.G8 (VSS), U5.G9 (VSSQ), U5.J2 (VSS), U5.J8 (VSS), U5.M1 (VSS), U5.M9 (VSS), U5.P1 (VSS), U5.P9 (VSS), U5.T1 (VSS), U5.T9 (VSS), Y1.3 (GND)
unnamed: R4.2, U2.L8 (ZQ)
unnamed: R7.2, U3.L8 (ZQ)
unnamed: R10.2, U4.L8 (ZQ)
unnamed: R13.2, U5.L8 (ZQ)
ODT: U2.K1 (ODT), U3.K1 (ODT), U4.K1 (ODT), U5.K1 (ODT)
RAS: U2.J3 (~RAS), U3.J3 (~RAS), U4.J3 (~RAS), U5.J3 (~RAS)
RESET: U2.T2 (~RESET), U3.T2 (~RESET), U4.T2 (~RESET), U5.T2 (~RESET)
VREF_0: U2.H1 (VREFDQ), U2.M8 (VREFCA), U5.H1 (VREFDQ), U5.M8 (VREFCA)
VREF_1: U3.H1 (VREFDQ), U3.M8 (VREFCA)
VREF_2: U4.H1 (VREFDQ), U4.M8 (VREFCA)
WE: U2.L3 (~WE), U3.L3 (~WE), U4.L3 (~WE), U5.L3 (~WE)
