silllies/uranus-fpga-board/(commit log)

2026-10-11 New entry and schematic
2026-10-11 fixed KiCad files
2026-10-11 and the schematic
2026-10-16 New journal entry, progress on schematic and PCB
2026-10-17 fixed BOM directory
2026-10-20 big things happening in schematic quality
2026-10-21 Big things have mostly happened in schematic quality
